zhiyuan1936/Si5351_6m_ft8/低通滤波器实物图.jpg

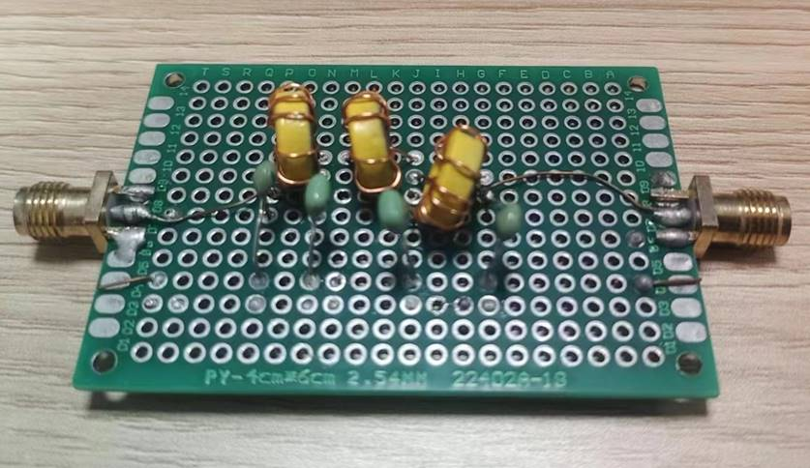
低通滤波器实物图.jpg
