zhiyuan1936/Si5351_6m_ft8/低通滤波器电路图.png

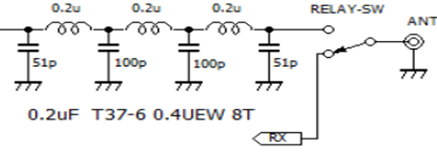
低通滤波器电路图.png
